MansoorAlmaleki/Laser-communication/(commit log)

2026-07-28 Laser communication
    a free space communication project
2026-07-28 Laser communication
2026-07-29 Fix typos and enhance wiring explanation in README
    Corrected a typo in the description of the Free Space Optical communication system and added details about the transmitter and receiver wiring.
2026-07-29 Add receiver calibration code snippet to README
    Added code snippet for receiver calibration in README.
2026-07-29 Add SIGNAL definition to README
    Added code snippet for defining the SIGNAL output pin.
